jainarya121/Arya_ProjX/BOM/BOM.md

# Bill of Materials (Task 4)

**Grand total ₹7,391.50 of the ₹10,000 budget, leaving ₹2,608.50 spare.** The editable spreadsheet with formulas is [BOM.xlsx](BOM.xlsx); the power-block diagram is [power_block_diagram.jpeg](power_block_diagram.jpeg).

## Cost

| # | Group | Item / exact model | Qty | Unit (₹) | Total (₹) | Supplier |
|---|---|---|---|---|---|---|
| 1 | Robot hardware | DOIT ESP32 DevKit V1 (ESP32-WROOM-32, 30-pin) | 1 | 385 | 385 | [Techiesms](https://techiesms.com/product/esp32-development-board-doit-devkit-v1/) |
| 2 | Robot hardware | TB6612FNG dual motor driver module — Probots PRO984 | 1 | 209 | 209 | [Probots](https://probots.co.in/tb6612fng-dual-channel-dc-motor-driver-module.html) |
| 3 | Robot hardware | N20 12 V 200 RPM micro metal gear motor with encoder | 2 | 559 | 1,118 | [Robu.in](https://robu.in/product/n20-12v-200rpm-micro-metal-gear-motor-with-encoder/) |
| 4 | Robot hardware | N20 motor mounting brackets (metal/plastic) | 2 | 40 | 80 | [Robu / local](https://robu.in/) |
| 5 | Robot hardware | 42 mm wheel for N20 motor, 3 mm D-hole (3PI miniQ style) | 2 | 59 | 118 | [Probots](https://probots.co.in/3pi-miniq-car-wheel-tyre-42mm-for-n20-motor.html) |
| 6 | Robot hardware | Metal ball caster for small robot car | 1 | 70 | 70 | [Robu / local](https://robu.in/) |
| 7 | Robot hardware | Pro-Range 11.1 V 1000 mAh 30C 3S LiPo battery (XT60) | 1 | 1,049 | 1,049 | [Robu.in](https://robu.in/product-category/3-cell-lipo-11-1v-12-6v/) |
| 8 | Robot hardware | Mini MP1584 adjustable buck converter | 1 | 75 | 75 | [Robu.in](https://robu.in/) |
| 9 | Robot hardware | TCRT5000 bare reflective sensor — 5-pack | 2 | 69 | 138 | [Robu.in](https://robu.in/product/tcrt5000-reflective-ir-sensor-photoelectric-switch/) |
| 10 | Robot hardware | FR4 perfboard 70×30 mm + 70×50 mm | 2 | 40 | 80 | [ElectronicsComp](https://www.electronicscomp.com/) |
| 11 | Robot hardware | Custom 3 mm acrylic chassis plate (~150×130 mm), laser cut | 1 | 350 | 350 | Local laser-cut shop |
| 12 | Robot hardware | Capacitor set: 470 µF 25 V ×2, 100 µF 25 V ×2, 0.1 µF X7R ×10, 10 nF ×10 | 1 | 100 | 100 | [ElectronicsComp](https://www.electronicscomp.com/) |
| 13 | Robot hardware | Resistor set: 220 Ω ×5, 10 kΩ ×10, 330 Ω, 100 kΩ + 22 kΩ | 1 | 50 | 50 | [ElectronicsComp](https://www.electronicscomp.com/) |
| 14 | Robot hardware | Red 5 mm indicator LEDs | 5 | 2 | 10 | [ElectronicsComp](https://www.electronicscomp.com/) |
| 15 | Robot hardware | R13-9 10 A, 12 V DC toggle switch | 1 | 49 | 49 | [BulkyBaba](https://www.bulkybaba.in/product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) |
| 16 | Robot hardware | 6 mm tactile push-buttons | 2 | 5 | 10 | [ElectronicsComp](https://www.electronicscomp.com/) |
| 17 | Robot hardware | XT60 connector pair (male + female) | 1 | 60 | 60 | [Robu.in](https://robu.in/) |
| 18 | Robot hardware | Silicone wire, 18 AWG red + black, 1 m each | 1 | 80 | 80 | [Robu.in](https://robu.in/) |
| 19 | Robot hardware | Dupont jumper wires (F-F and M-F), 40 pcs | 1 | 80 | 80 | [Robu.in](https://robu.in/) |
| 20 | Robot hardware | JST-PH/XH connector kit for motor/encoder leads | 1 | 60 | 60 | [Robu.in](https://robu.in/) |
| 21 | Robot hardware | Female headers for ESP32 and driver module | 1 | 40 | 40 | [ElectronicsComp](https://www.electronicscomp.com/) |
| 22 | Robot hardware | M2/M3 screws, nuts and nylon standoff kit | 1 | 150 | 150 | [Robu.in](https://robu.in/) |
| 23 | Robot hardware | Heat-shrink, zip ties and double-sided foam tape | 1 | 80 | 80 | [Local / Robu](https://robu.in/) |
| 24 | Robot hardware | XL4015 adjustable buck converter for motor rail | 1 | 86.50 | 86.50 | [KTRON](https://www.ktron.in/product/xl4015-step-down-module/) |
| 25 | Robot hardware | Inline fuse holder + provisional fuse allowance | 1 | 50 | 50 | [Local / electronics supplier](https://www.electronicscomp.com/) |
| 26 | Tools / spares | IMAX B3 Pro compact balance charger for 2S/3S LiPo | 1 | 499 | 499 | [Probots](https://probots.co.in/imax-b3-pro-balance-charger-for-2s-3s-lipo-battery.html) |
| 27 | Tools / spares | LiPo cell checker / low-voltage buzzer (1–8S) | 1 | 90 | 90 | [Robu.in](https://robu.in/) |
| 28 | Tools / spares | Spare TB6612FNG driver module — Probots PRO984 | 1 | 209 | 209 | [Probots](https://probots.co.in/tb6612fng-dual-channel-dc-motor-driver-module.html) |
| 29 | Tools / spares | Spare N20 12 V 200 RPM encoder motor | 1 | 559 | 559 | [Robu.in](https://robu.in/product/n20-12v-200rpm-micro-metal-gear-motor-with-encoder/) |
| 30 | Tools / spares | Spare DOIT ESP32 DevKit V1 (ESP32-WROOM-32) | 1 | 385 | 385 | [Techiesms](https://techiesms.com/product/esp32-development-board-doit-devkit-v1/) |
| 31 | Logistics | Shipping allowance across suppliers | 1 | 400 | 400 | Multiple suppliers |

| Summary | ₹ |
|---|---|
| Robot hardware subtotal | 4,577.50 |
| Tools / spares subtotal | 1,742 |
| Shipping allowance | 400 |
| Subtotal before contingency | 6,719.50 |
| Contingency (10%, rounded up) | 672 |
| **Grand total** | **7,391.50** |
| Budget headroom | 2,608.50 |

## Specifications and rationale

| # | Item | Key specifications / constraints | Why selected | Purchasing note |
|---|---|---|---|---|
| 1 | DOIT ESP32 DevKit V1 (ESP32-WROOM-32, 30-pin) | ESP32-WROOM-32; dual-core up to 240 MHz; Wi-Fi + Bluetooth Classic/BLE; 12-bit ADC. | Required controller; WROOM-32 supports Classic Bluetooth SPP for later diagnostics. | Live listing price; confirm exact module variant before ordering. |
| 2 | TB6612FNG dual motor driver module — Probots PRO984 | Module listing: VM 4.5–10 V; logic 2.7–5.5 V; dual MOSFET H-bridge; STBY pin. | More efficient and compact than L298N, but requires a regulated motor rail at 9.0 V. | Live listing. Do NOT connect this module's VM directly to a 3S LiPo. |
| 3 | N20 12 V 200 RPM micro metal gear motor with encoder | 12 V nominal; 200 RPM listed; encoder; 3 mm D-shaft. Exact stall current/resolution must be confirmed. | Lower speed than 300 RPM is easier to control near junctions; encoders support later localization. | Live category/product listing price; confirm current price and exact electrical specs. |
| 4 | N20 motor mounting brackets (metal/plastic) | Fit N20 gearbox dimensions and chosen chassis; verify M1.6/M2 hole pattern. | Secure motors without fabricating custom gearbox parts. | Budget estimate; source exact bracket SKU before purchase. |
| 5 | 42 mm wheel for N20 motor, 3 mm D-hole (3PI miniQ style) | 42 mm outer diameter; 3 mm D-bore; rubber tyre. | At 200 RPM, theoretical no-load wheel speed is about 0.44 m/s; actual speed will be lower under load and at 9 V. | Listed estimate from supplied BOM; verify fit on exact shaft. |
| 6 | Metal ball caster for small robot car | Compact ball caster; exact height/hole spacing to be checked against chassis. | Provides a third support point; shim so chassis is level and sensors sit close to floor. | Budget estimate; select exact mounting dimensions. |
| 7 | Pro-Range 11.1 V 1000 mAh 30C 3S LiPo battery (XT60) | 11.1 V nominal; 12.6 V fully charged; 1000 mAh; 30C label; XT60 variant must be confirmed. | Meets the reference 3S nominal battery rail; enough capacity for a compact robot if current/runtime checks pass. | Live category listing includes this model at ₹1,049; confirm connector and stock. |
| 8 | Mini MP1584 adjustable buck converter | Typical module input 4.5–28 V; adjustable output; seller-rated 3 A maximum (board cooling matters). | Set to 5.0 V for ESP32 VIN/5V input; measure with a multimeter before connecting. | Budget estimate; confirm module's actual input/current specs. |
| 9 | TCRT5000 bare reflective sensor — 5-pack | Each contains IR emitter + phototransistor; supplier lists 5 sensors per pack. | Two packs provide 10 parts: five for a custom analog array and five spares; use resistor circuits, not a comparator-only digital board. | Live listing ₹69 per pack; confirm the listing is the bare sensor pack, not a digital module. |
| 10 | FR4 perfboard 70×30 mm + 70×50 mm | 2.54 mm pitch; one small sensor board and one main wiring board. | Keeps sensor spacing fixed and gives a place for robust power distribution. | Budget estimate; no exact SKU URL. |
| 11 | Custom 3 mm acrylic chassis plate (~150×130 mm), laser cut | Approximate 150×130 mm footprint; finalize CAD/drawing to competition size limits. | Custom plate avoids relying on a ready-made robot kit and can position sensor array precisely. | Local quote estimate; obtain quote after final drawing. |
| 12 | Capacitor set: 470 µF 25 V ×2, 100 µF 25 V ×2, 0.1 µF X7R ×10, 10 nF ×10 | Use voltage ratings above the rail; 25 V electrolytics provide margin over 12.6 V battery. | Bulk capacitance helps transient response; 0.1 µF ceramic near motor terminals; sensor input filtering as required. | Budget estimate. Do not rely on capacitors supplied on the driver board without checking their voltage rating. |
| 13 | Resistor set: 220 Ω ×5, 10 kΩ ×10, 330 Ω, 100 kΩ + 22 kΩ | ¼ W resistors; values for IR LED current limiting, phototransistor loads, indicators and optional battery divider. | Supports a custom analog TCRT5000 circuit and simple status indication. | Budget estimate; verify IR LED current from the circuit design. |
| 14 | Red 5 mm indicator LEDs | Typical red LED Vf around 2 V; use series resistor. | One can be used for the required END indicator; remaining LEDs are spares. | Estimate per LED. |
| 15 | R13-9 10 A, 12 V DC toggle switch | Seller advertises 10 A at 12 V DC; panel-mount toggle. | Use a DC-rated switch rather than relying on an AC-only rating. | Live listing observed around ₹45–₹49; budgeted at ₹49. |
| 16 | 6 mm tactile push-buttons | Momentary tactile switches. | One for START and one spare; use debounce in firmware. | Budget estimate. |
| 17 | XT60 connector pair (male + female) | Keyed high-current battery connector; confirm polarity before soldering. | Robust detachable battery connection. | Budget estimate; inspect connector gender/polarity. |
| 18 | Silicone wire, 18 AWG red + black, 1 m each | Flexible insulated wire; use appropriate gauge for battery-to-driver path. | Carries battery and motor power more reliably than thin Dupont jumpers. | Budget estimate. |
| 19 | Dupont jumper wires (F-F and M-F), 40 pcs | Bench signal wiring. | Useful for initial prototyping; solder/secure final competition wiring. | Budget estimate. |
| 20 | JST-PH/XH connector kit for motor/encoder leads | Connector pitch and pin count must match the selected motor encoder cable. | Allows motor/encoder replacement between runs. | Budget estimate; verify exact connector pitch. |
| 21 | Female headers for ESP32 and driver module | 2.54 mm pitch. | Makes modules replaceable without desoldering during debugging. | Budget estimate. |
| 22 | M2/M3 screws, nuts and nylon standoff kit | Mixed small hardware. | Mounts motors, boards and chassis securely. | Budget estimate. |
| 23 | Heat-shrink, zip ties and double-sided foam tape | Insulation and strain-relief materials. | Prevents wire movement and helps retain the battery safely. | Budget estimate. |
| 24 | XL4015 adjustable buck converter for motor rail | Seller lists 8–36 V input, adjustable output, 5 A module rating; module thermal rating depends on conditions. | Set and verify output at 9.0 V before connecting TB6612FNG PRO984, whose board listing says VM 4.5–10 V. | Live listing ₹86.50 incl. GST; do not treat the 5 A headline as guaranteed continuous output in all conditions. |
| 25 | Inline fuse holder + provisional fuse allowance | Fuse rating must be selected after confirming motor startup/stall current and wire rating. | Adds protection against battery-side wiring faults; place close to battery positive. | Budget estimate; do not choose fuse solely from average running current. |
| 26 | IMAX B3 Pro compact balance charger for 2S/3S LiPo | For 2S/3S LiPo packs; verify wall plug and charger connector match. | A compatible balance charger is required for safe charging of the 3S pack. | Live listing around ₹489–₹499; budgeted at ₹499. |
| 27 | LiPo cell checker / low-voltage buzzer (1–8S) | Shows individual cell voltages and alarms on low voltage; exact model varies. | Helps avoid over-discharging a LiPo pack. | Budget estimate; confirm model supports 3S. |
| 28 | Spare TB6612FNG driver module — Probots PRO984 | Same module as primary driver. | Allows a rapid hardware swap if the driver is damaged. | Live listing price. |
| 29 | Spare N20 12 V 200 RPM encoder motor | Use the same winding, gearbox ratio and encoder model as the main pair. | Keeps replacement hardware consistent with tuning. | Live listing/category price; confirm exact current/encoder details. |
| 30 | Spare DOIT ESP32 DevKit V1 (ESP32-WROOM-32) | Same board variant as primary controller. | Pre-flashed backup can reduce downtime. | Live listing price. |
| 31 | Shipping allowance across suppliers | Estimated combined shipping and delivery charges. | Covers orders placed below free-shipping thresholds. | Planning allowance; update with checkout totals. |

## Component choice: motor driver

**TB6612FNG chosen over the L298N in Appendix A.** It is more efficient and more compact than the L298N, but it needs a regulated motor rail at 9.0 V: its VM must not be connected straight to the 3S LiPo. The supply limits behind this are in [Task 2](../docs/task2_datasheet.md).

## Power

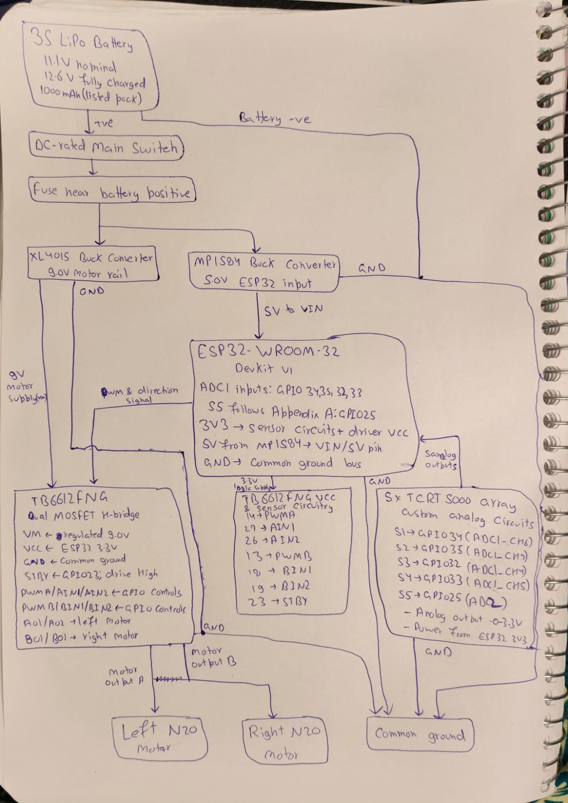
[picture p3: BOM/power_block_diagram.jpeg]
Power-block diagram


The power budget and the LiPo vs Li-ion comparison are in [power_budget.md](power_budget.md).
